K-01/TOAZ/README.txt

TOAZ [Transformative Orientation-Aware Zootype] is licensed under a Creative Commons Attribution ShareAlike 4.0 United States License.
The full terms of this license can be read at:
http://creativecommons.org/licenses/by-sa/4.0/
