K-01/TOAZ/MEDIA/TOAZ_A.png

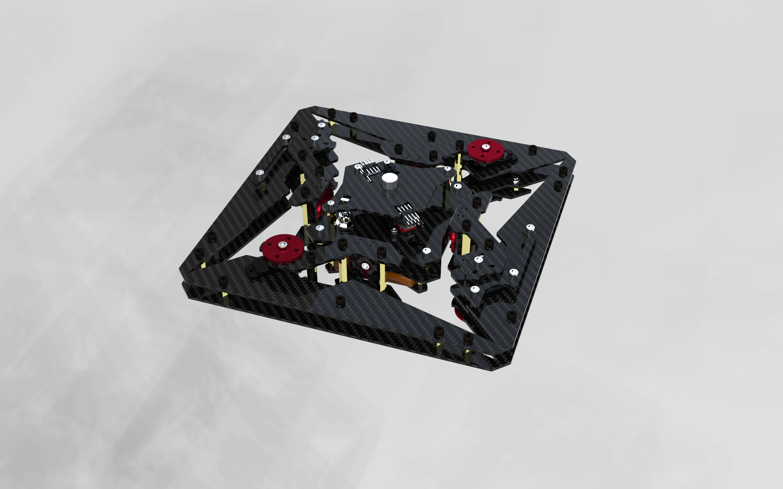
MEDIA/TOAZ_A.png
