K-01/TOAZ/MEDIA/TOAZ_B.png

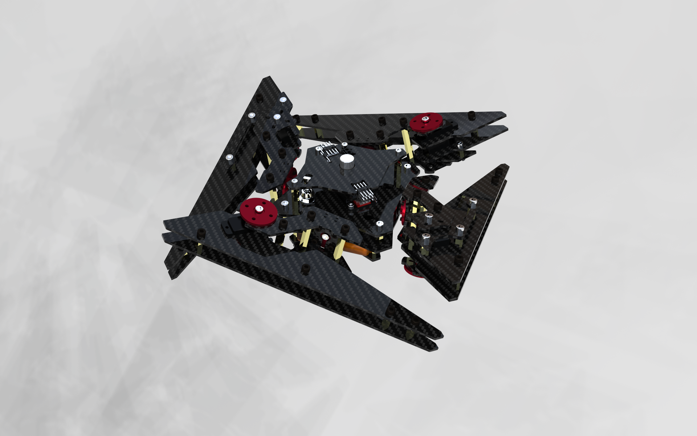
MEDIA/TOAZ_B.png
