K-01/TOAZ/MEDIA/TOAZ_C.png

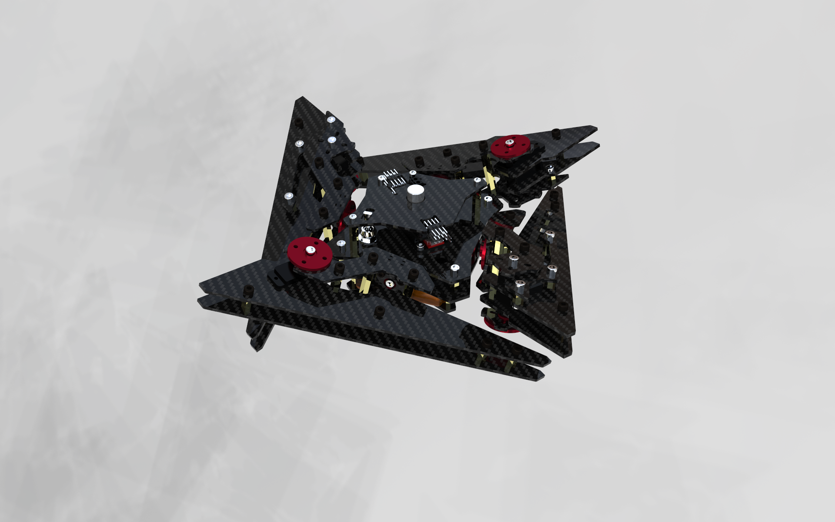
MEDIA/TOAZ_C.png
