K-01/TOAZ/MEDIA/TOAZ_D.png

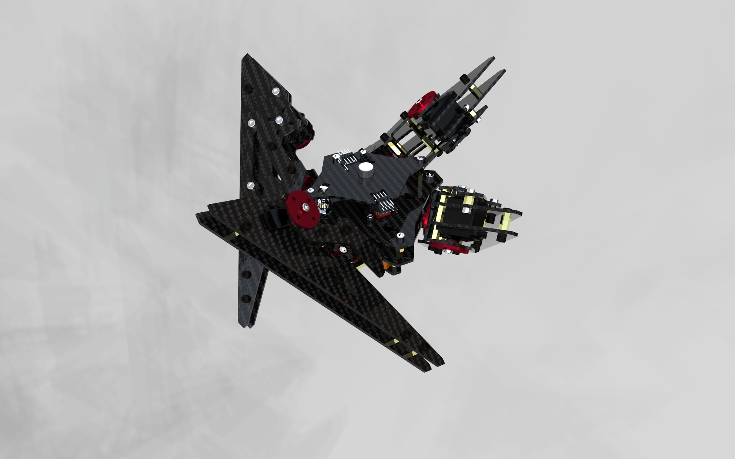
MEDIA/TOAZ_D.png
