K-01/TOAZ/MEDIA/TOAZ_E.png

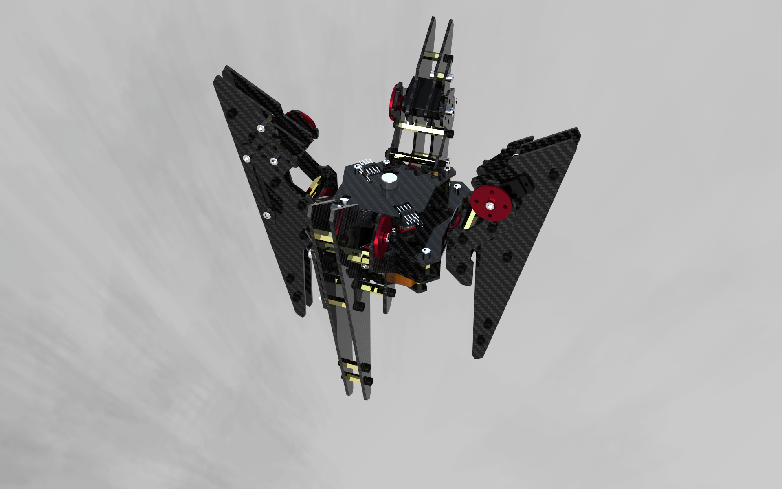
MEDIA/TOAZ_E.png
