K-01/TOAZ/MEDIA/TOAZ_F.png

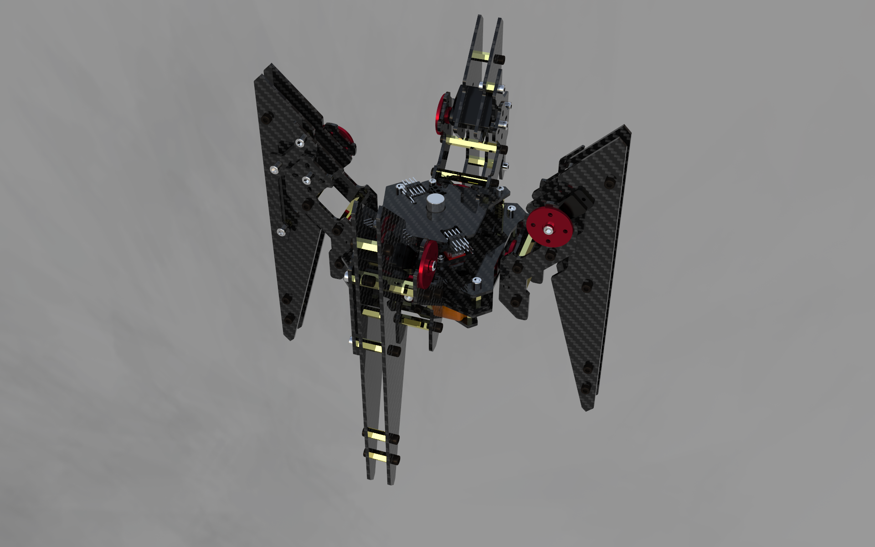
MEDIA/TOAZ_F.png
