K-01/TOAZ/MEDIA/TOAZ_G.png

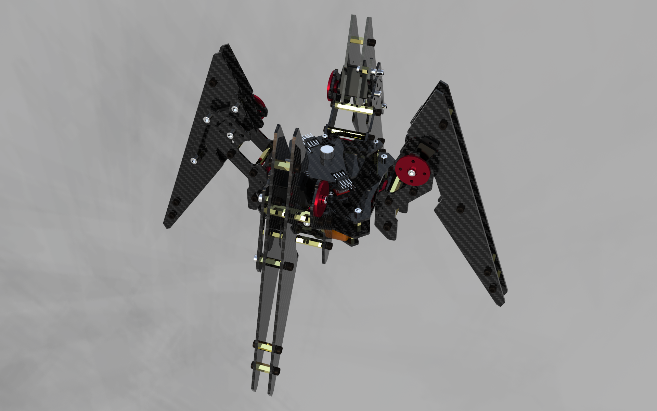
MEDIA/TOAZ_G.png
