K-01/TOAZ/MEDIA/TOAZ_H.png

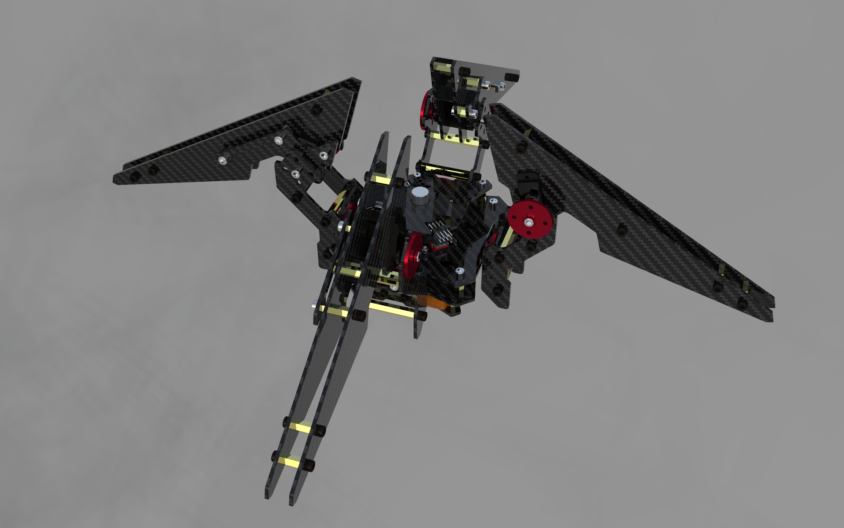
MEDIA/TOAZ_H.png
