K-01/TOAZ/MEDIA/TOAZ_I.png

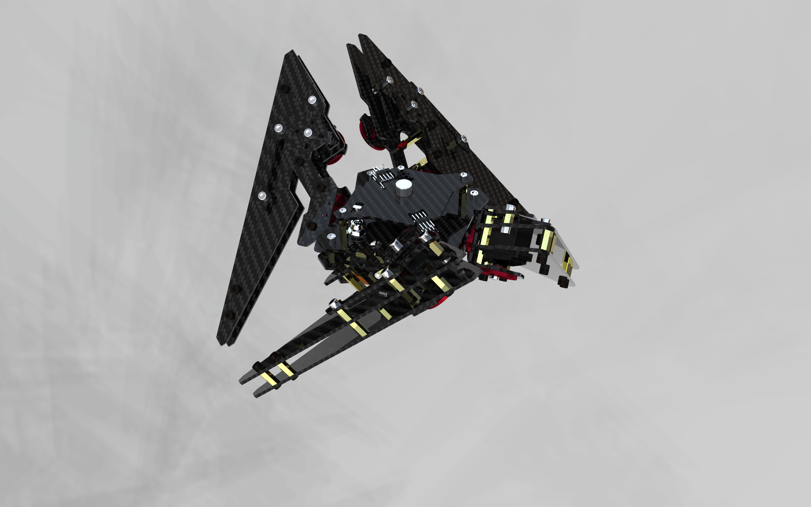
MEDIA/TOAZ_I.png
