K-01/TOAZ/MEDIA/TOAZ_J.png

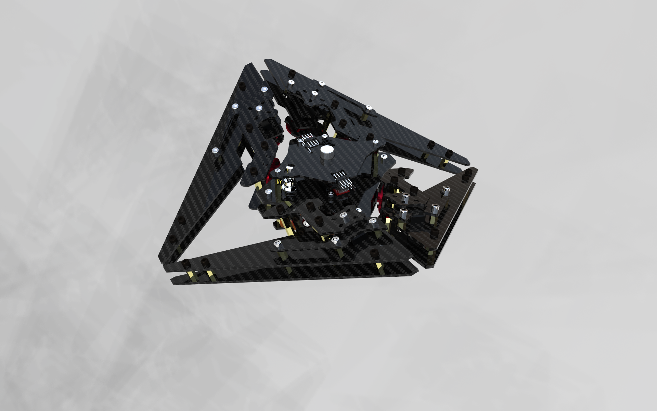
MEDIA/TOAZ_J.png
