K-01/TOAZ/MEDIA/TOAZ_K.png

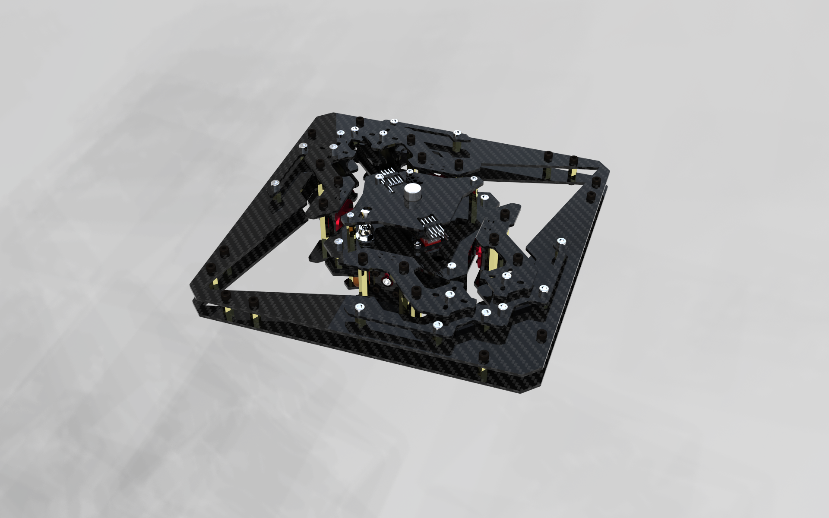
MEDIA/TOAZ_K.png
