K-01/TOAZ/3D-STL/Trochanter_Plate_B.stl

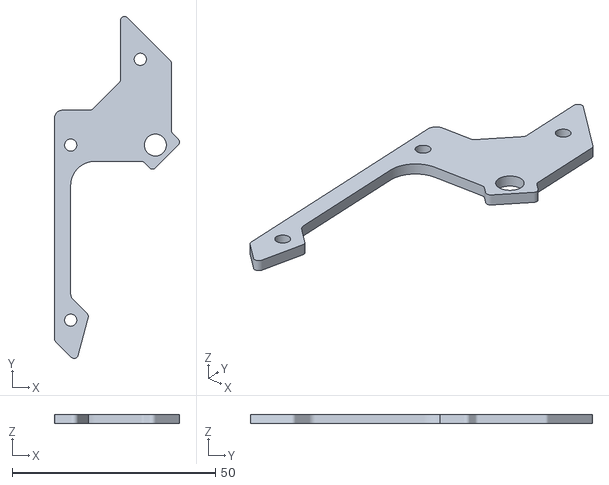
[picture p12: CAD file, 2017-03-28]
3D-STL/Trochanter_Plate_B.stl
30.8 x 84.2 x 2.20
