K-01/TOAZ/3D-STL/Mid_Body_Mount_Plate_B.stl

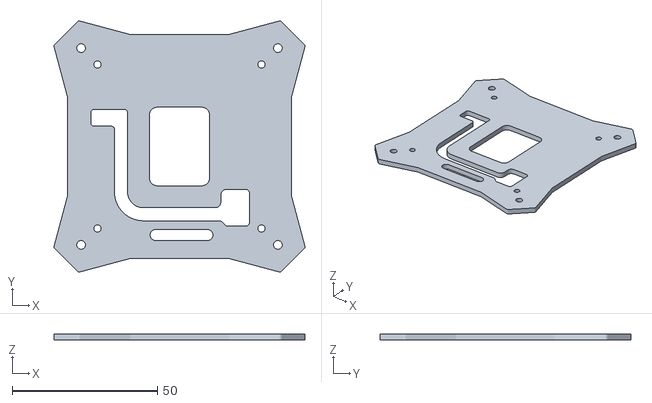
[picture p14: CAD file, 2017-03-28]
3D-STL/Mid_Body_Mount_Plate_B.stl
86.5 x 86.5 x 2.20
