K-01/TOAZ/3D-STL/Mid_Body_Mount_Plate_A.stl

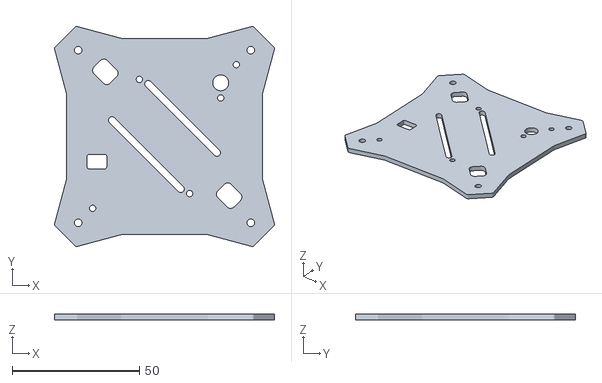
[picture p16: CAD file, 2017-03-28]
3D-STL/Mid_Body_Mount_Plate_A.stl
86.5 x 86.5 x 2.20
