K-01/TOAZ/3D-STL/Coxa_Plate_I-B_X2.stl

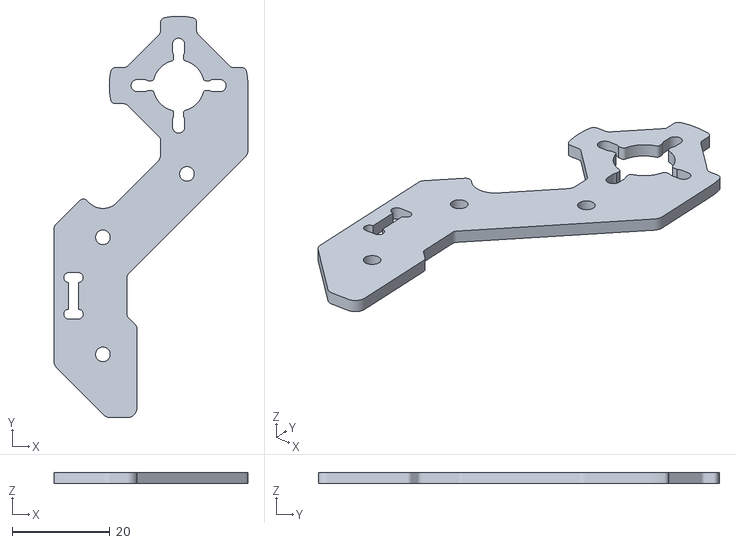
[picture p17: CAD file, 2017-03-28]
3D-STL/Coxa_Plate_I-B_X2.stl
39.8 x 82.3 x 2.20
