K-01/TOAZ/3D-STL/Femur_Plate_II-A_X2.stl

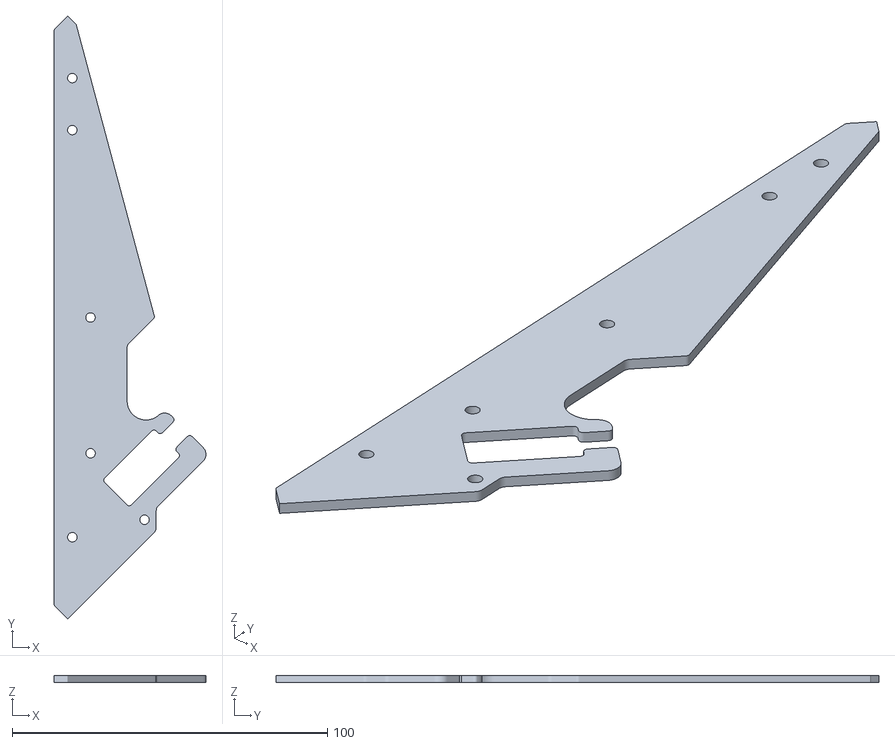
[picture p18: CAD file, 2017-03-28]
3D-STL/Femur_Plate_II-A_X2.stl
48.2 x 191.3 x 2.20
