K-01/TOAZ/3D-STL/Servo_Arm_Mount_Plate_X4.stl

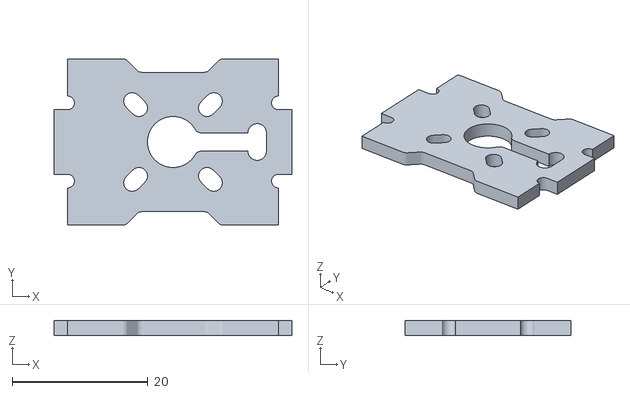
[picture p19: CAD file, 2017-03-28]
3D-STL/Servo_Arm_Mount_Plate_X4.stl
35.0 x 24.5 x 2.20
