K-01/TOAZ/3D-STL/Top_Body_Cover.stl

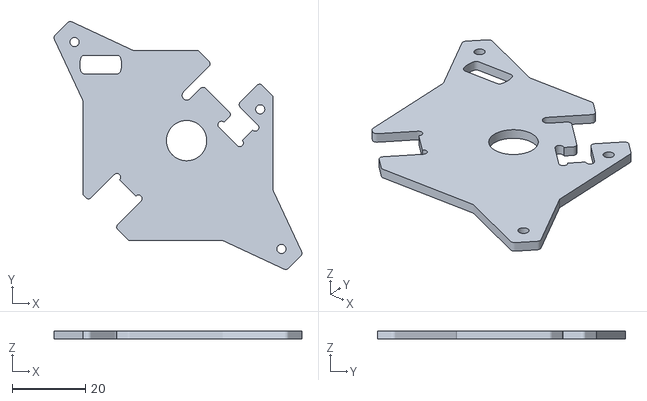
[picture p21: CAD file, 2017-03-28]
3D-STL/Top_Body_Cover.stl
67.7 x 67.7 x 2.20
