K-01/TOAZ/3D-STL/Mid_Body_Servo_Plate_B.stl

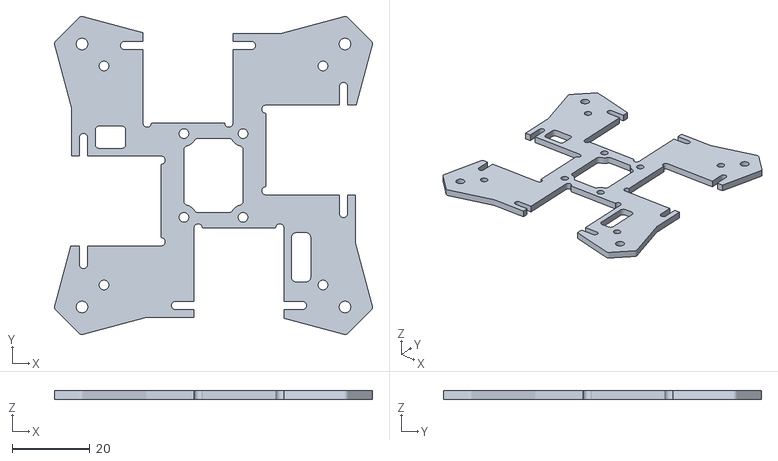
[picture p22: CAD file, 2017-03-28]
3D-STL/Mid_Body_Servo_Plate_B.stl
82.0 x 82.0 x 2.20
