K-01/TOAZ/(list of files, cad)

Other CAD files:
3D-STL/Trochanter_Plate_A.stl
3D-STL/Femur_Plate_II-B_X2.stl
3D-STL/Femur_Plate_I-A_X2.stl
3D-STL/Coxa_Plate_I-A_X2.stl
3D-STL/Coxa_Plate_II-B_X2.stl
