K-01/TOAZ/CAD/TOAZ_V2.2.pdf

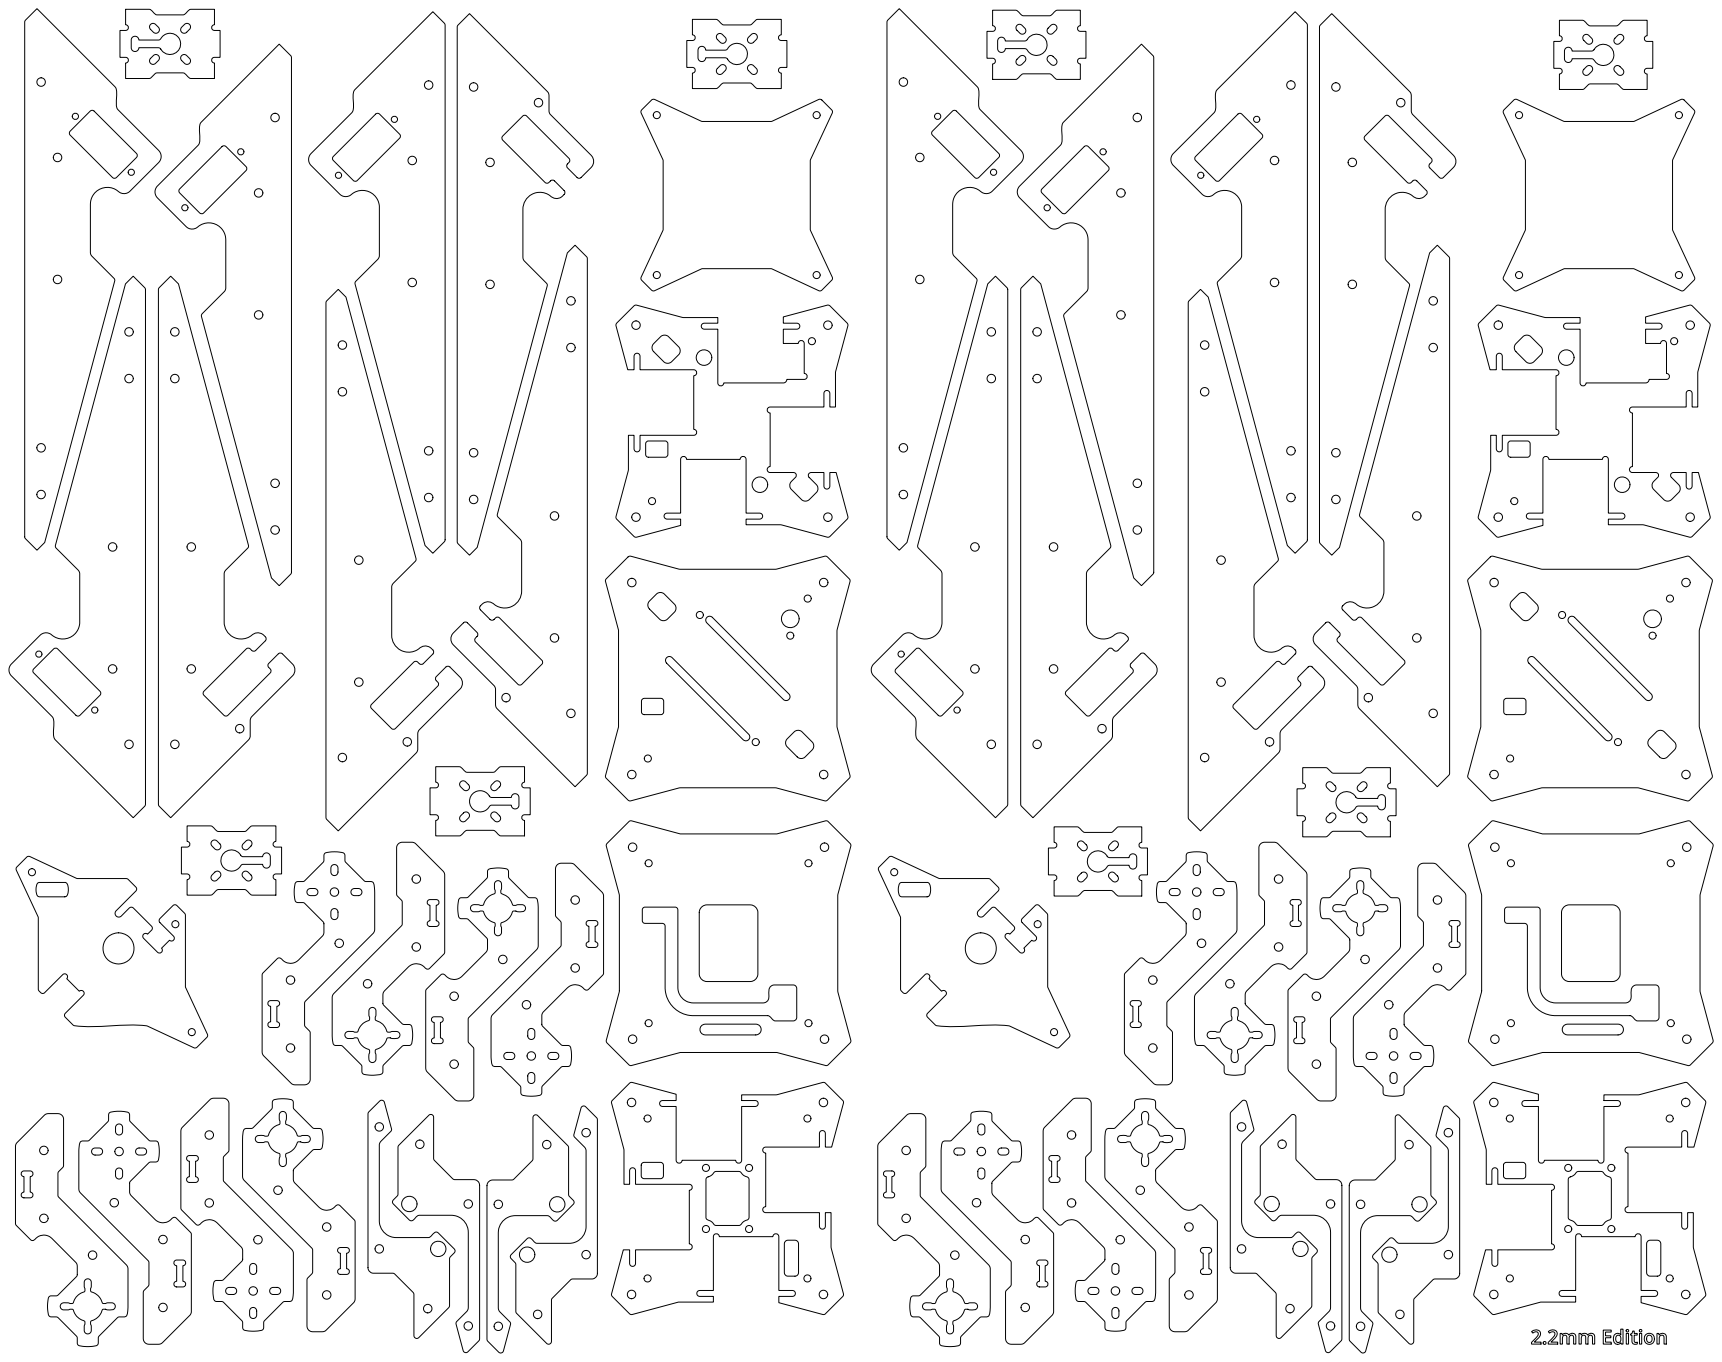
[picture p24: page 1]
